dustin-lehmann/bilbolab/software/extensions/apps/content_server/content/thumbnails/db9c836b_thumb.jpg

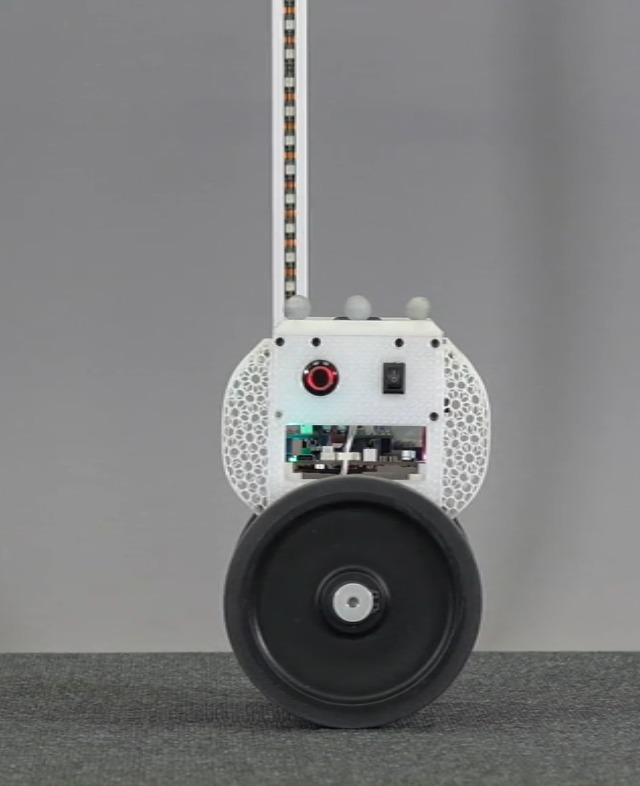
software/extensions/apps/content_server/content/thumbnails/db9c836b_thumb.jpg
