dustin-lehmann/bilbolab/software/extensions/apps/content_server/content/thumbnails/b7924501_thumb.jpg

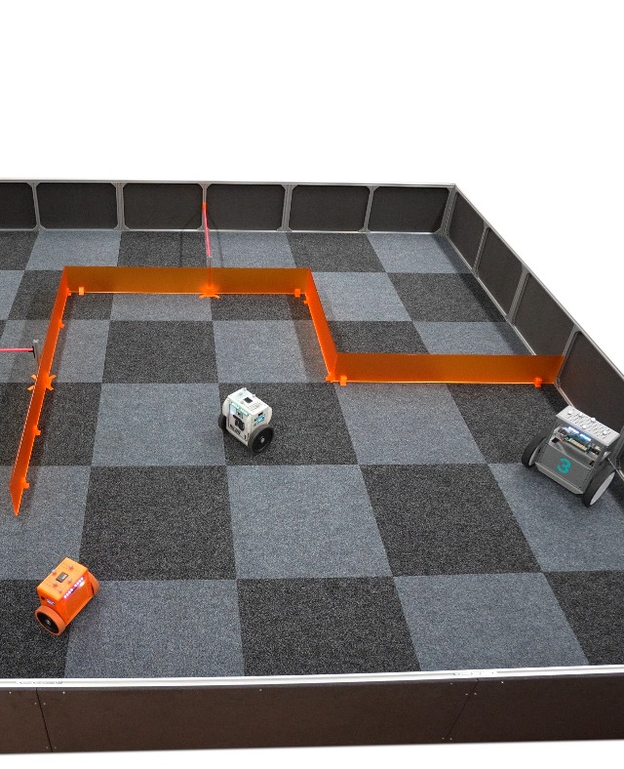
software/extensions/apps/content_server/content/thumbnails/b7924501_thumb.jpg
