dustin-lehmann/bilbolab/software/extensions/apps/content_server/pdfs/full_schematic.pdf

## Complete Schematics

Placeholder Document

Page 1 of 3

Complete Schematics - Content

Page 2 of 3

Complete Schematics - Summary

Page 3 of 3
