dustin-lehmann/bilbolab/software/extensions/apps/content_server/pdfs/main_pcb_schematic.pdf

## Main PCB Schematic

Placeholder Document

Page 1 of 3

Main PCB Schematic - Content

Page 2 of 3

Main PCB Schematic - Summary

Page 3 of 3
