dustin-lehmann/bilbolab/software/robots/bilbo/tools/plotting/examples/output/lines.pdf

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

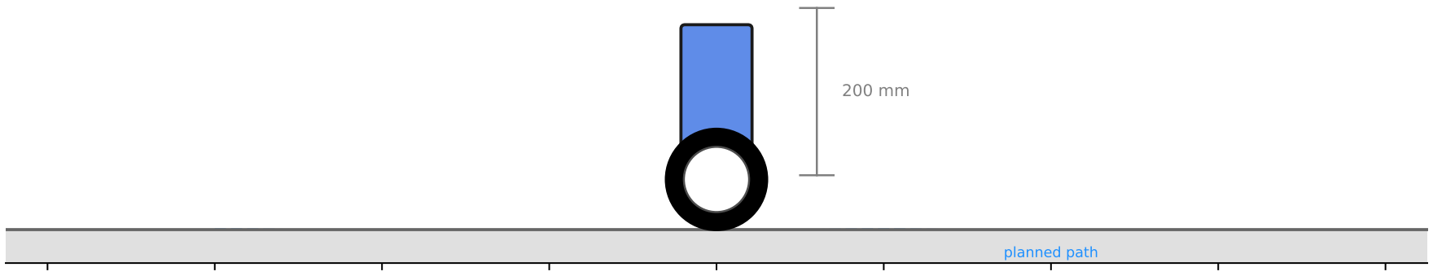
[picture p4: figure]
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
