dustin-lehmann/bilbolab/software/core/utils/plotting/examples/plot_latex.png

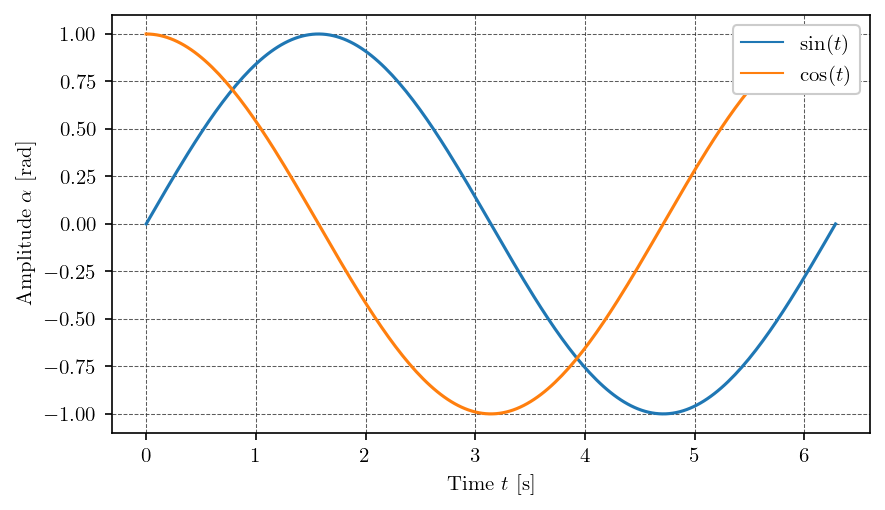
software/core/utils/plotting/examples/plot_latex.png
