dustin-lehmann/bilbolab/software/extensions/apps/content_server/content/folders/b358b188/subfolders/ef9b0147/items/b7924501/files/placeholder.png

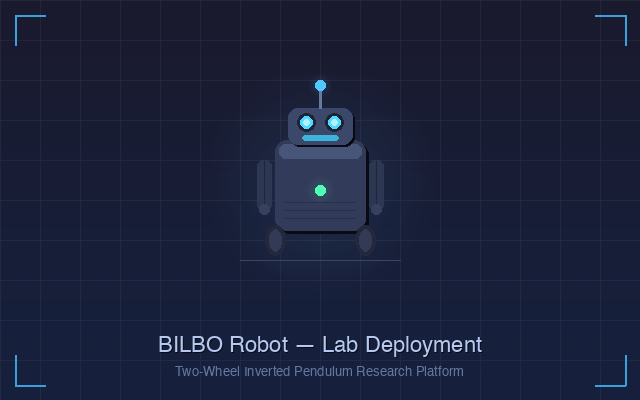
software/extensions/apps/content_server/content/folders/b358b188/subfolders/ef9b0147/items/b7924501/files/placeholder.png
