dustin-lehmann/bilbolab/software/extensions/apps/content_server/content/thumbnails/b230edec_thumb.jpg

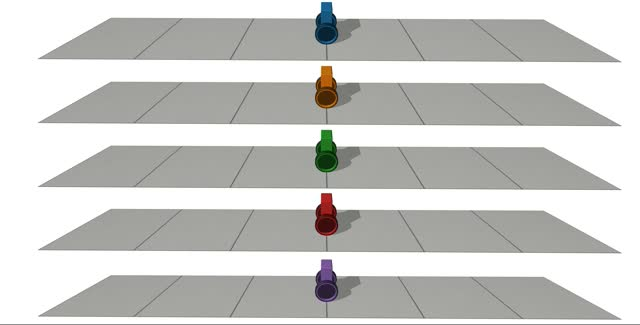
software/extensions/apps/content_server/content/thumbnails/b230edec_thumb.jpg
