dustin-lehmann/bilbolab/software/extensions/apps/content_server/content/thumbnails/thumbnail.jpg

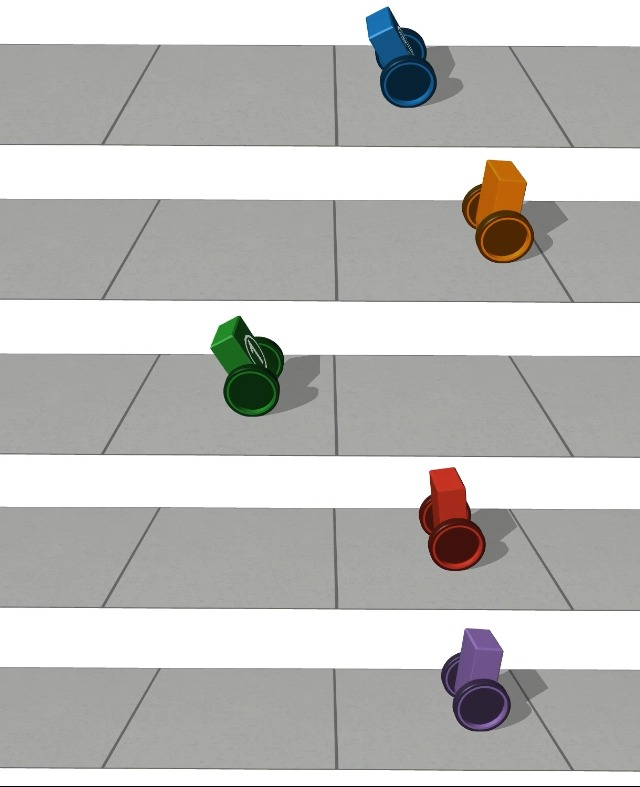
software/extensions/apps/content_server/content/thumbnails/thumbnail.jpg
