dustin-lehmann/bilbolab/software/extensions/apps/content_server/figures/chapter_deps.png

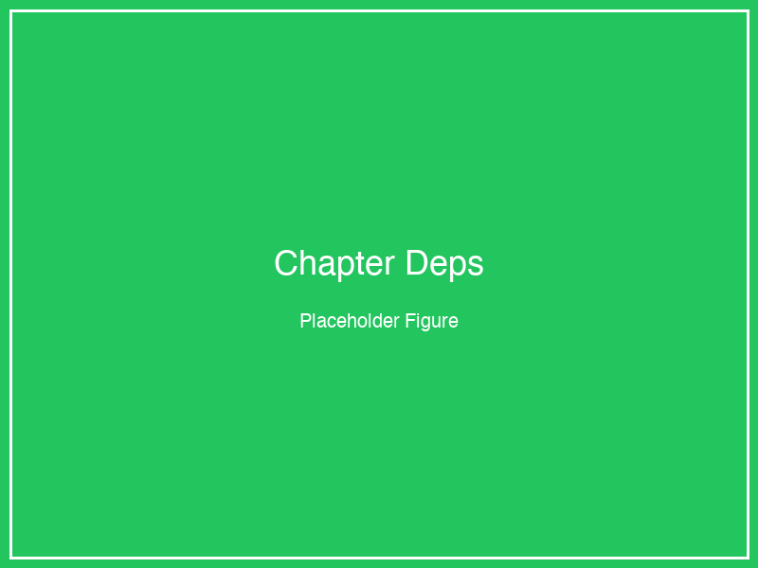
software/extensions/apps/content_server/figures/chapter_deps.png
