dustin-lehmann/bilbolab/software/extensions/apps/content_server/thumbnails/balancing_control.png

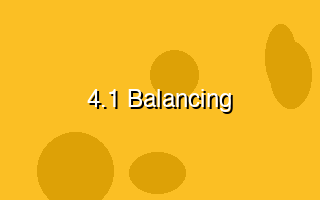
software/extensions/apps/content_server/thumbnails/balancing_control.png
