dustin-lehmann/bilbolab/software/extensions/apps/content_server/thumbnails/control.png

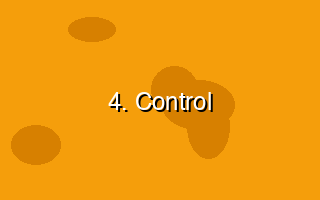
software/extensions/apps/content_server/thumbnails/control.png
