dustin-lehmann/bilbolab/software/extensions/apps/content_server/thumbnails/disturbance_rejection.png

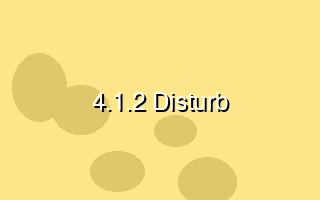
software/extensions/apps/content_server/thumbnails/disturbance_rejection.png
