dustin-lehmann/bilbolab/software/extensions/apps/content_server/thumbnails/dynamic_model.png

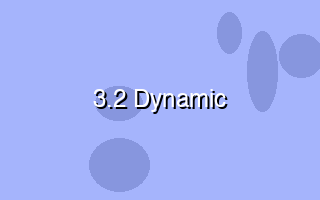
software/extensions/apps/content_server/thumbnails/dynamic_model.png
