dustin-lehmann/bilbolab/software/extensions/apps/content_server/thumbnails/estimation.png

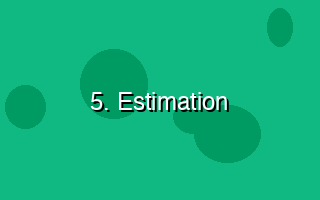
software/extensions/apps/content_server/thumbnails/estimation.png
