dustin-lehmann/bilbolab/software/extensions/apps/content_server/thumbnails/interactive.png

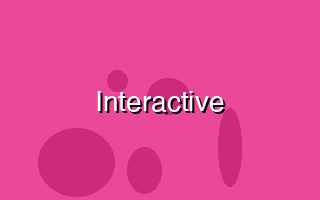
software/extensions/apps/content_server/thumbnails/interactive.png
