dustin-lehmann/bilbolab/software/extensions/apps/content_server/thumbnails/kinematic_model.png

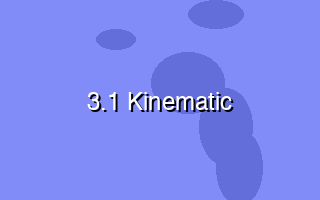
software/extensions/apps/content_server/thumbnails/kinematic_model.png
