dustin-lehmann/bilbolab/software/extensions/apps/content_server/thumbnails/lqr_design.png

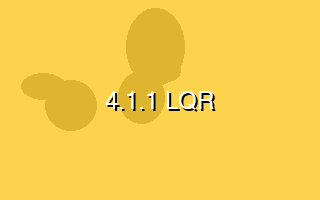
software/extensions/apps/content_server/thumbnails/lqr_design.png
