dustin-lehmann/bilbolab/software/extensions/apps/content_server/thumbnails/modeling.png

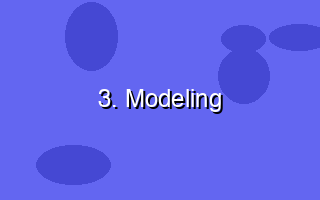
software/extensions/apps/content_server/thumbnails/modeling.png
