dustin-lehmann/bilbolab/software/extensions/apps/content_server/thumbnails/point_to_point.png

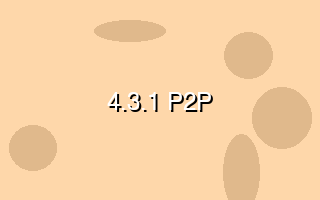
software/extensions/apps/content_server/thumbnails/point_to_point.png
