dustin-lehmann/bilbolab/software/extensions/apps/content_server/thumbnails/position_control.png

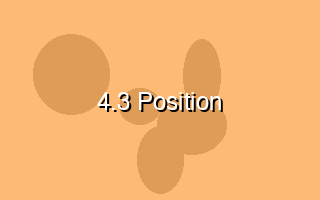
software/extensions/apps/content_server/thumbnails/position_control.png
