dustin-lehmann/bilbolab/software/extensions/apps/content_server/thumbnails/trajectory_following.png

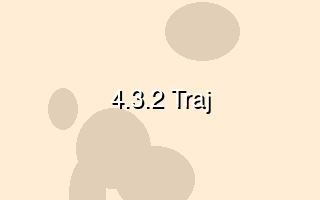
software/extensions/apps/content_server/thumbnails/trajectory_following.png
