dustin-lehmann/bilbolab/software/extensions/apps/content_server/thumbnails/velocity_control.png

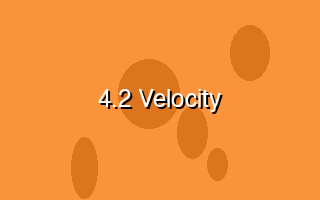
software/extensions/apps/content_server/thumbnails/velocity_control.png
