dustin-lehmann/bilbolab/software/extensions/apps/content_server/thumbnails/videos.png

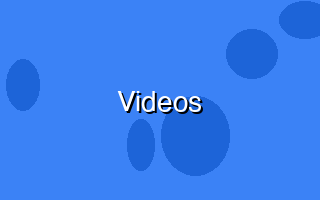
software/extensions/apps/content_server/thumbnails/videos.png
