dustin-lehmann/bilbolab/software/robots/bilbo/configs/references/bumped_reference_harder_break_gentle.png

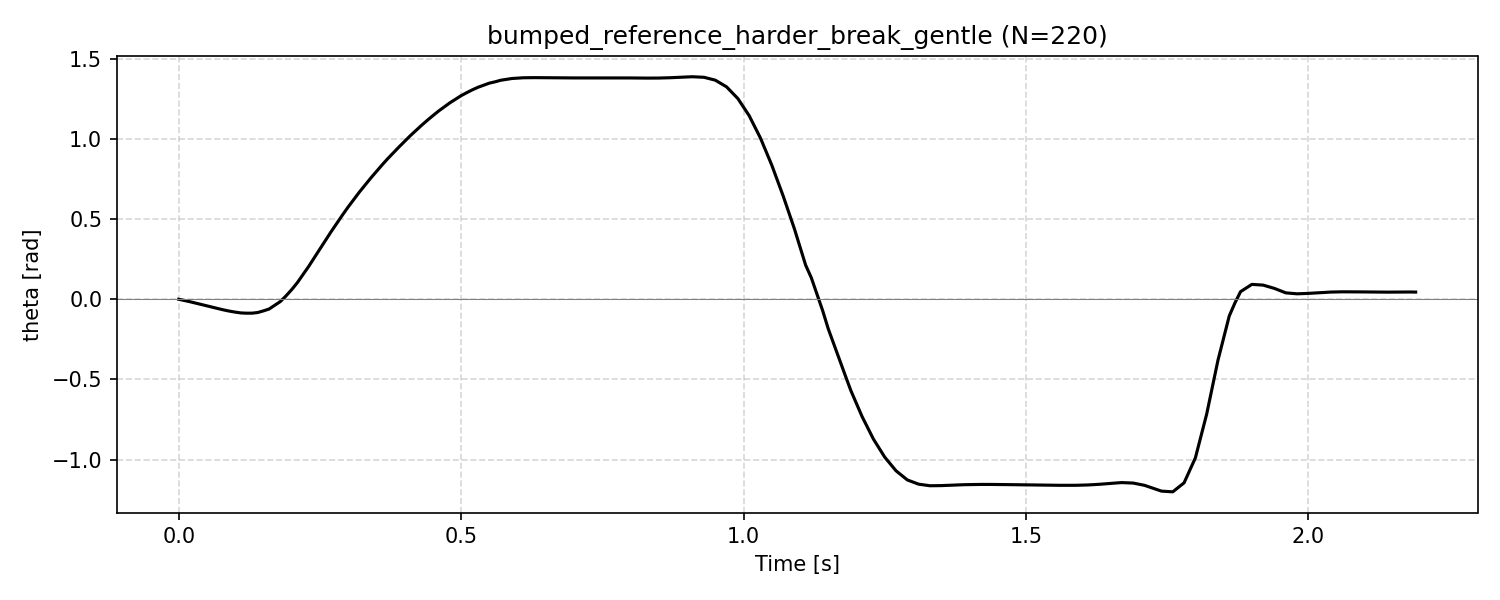
software/robots/bilbo/configs/references/bumped_reference_harder_break_gentle.png
