dustin-lehmann/bilbolab/software/robots/bilbo/tools/plotting/examples/output/lines.png

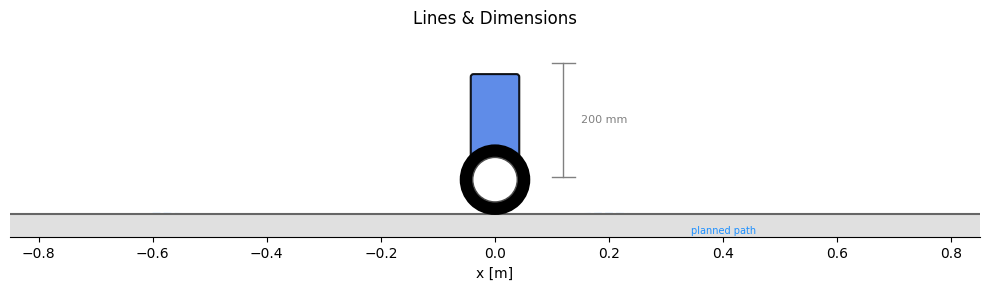
software/robots/bilbo/tools/plotting/examples/output/lines.png
