dustin-lehmann/bilbolab/software/robots/bilbo/tools/plotting/examples/output/multiple_bilbos.png

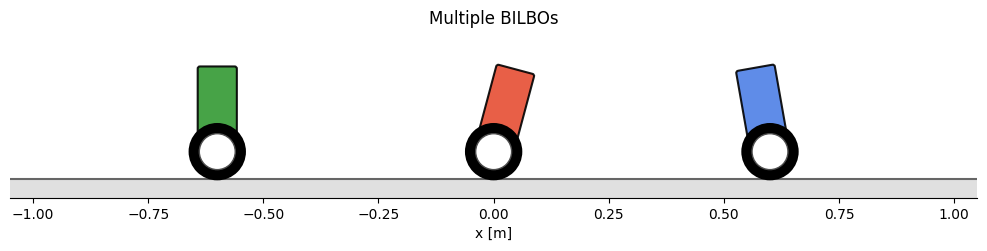
software/robots/bilbo/tools/plotting/examples/output/multiple_bilbos.png
