dustin-lehmann/bilbolab/software/extensions/apps/content_server/pdfs/bom.pdf

## Bill of Materials

Placeholder Document

Page 1 of 3

Bill of Materials - Content

Page 2 of 3

Bill of Materials - Summary

Page 3 of 3
