dustin-lehmann/bilbolab/material/expo/Anleitung_Stand-EF-11_IdeenExpo_2 copy.pdf

## STEUERUNG BALANCIERENDER ROBOTER

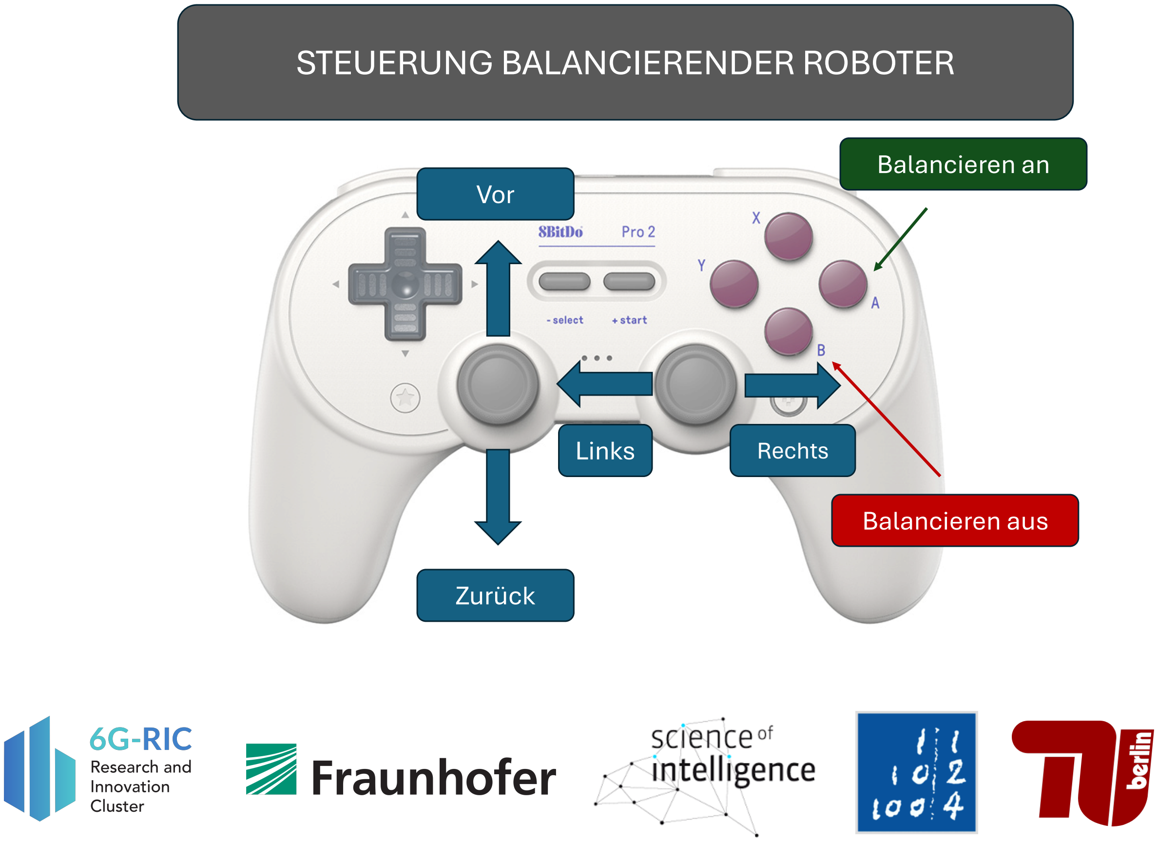
[picture p29: page 1]

Vor

Zurück

Links | Rechts

Balancieren an

Balancieren aus
