dustin-lehmann/bilbolab/software/robots/bilbo/configs/references/ref_test.png

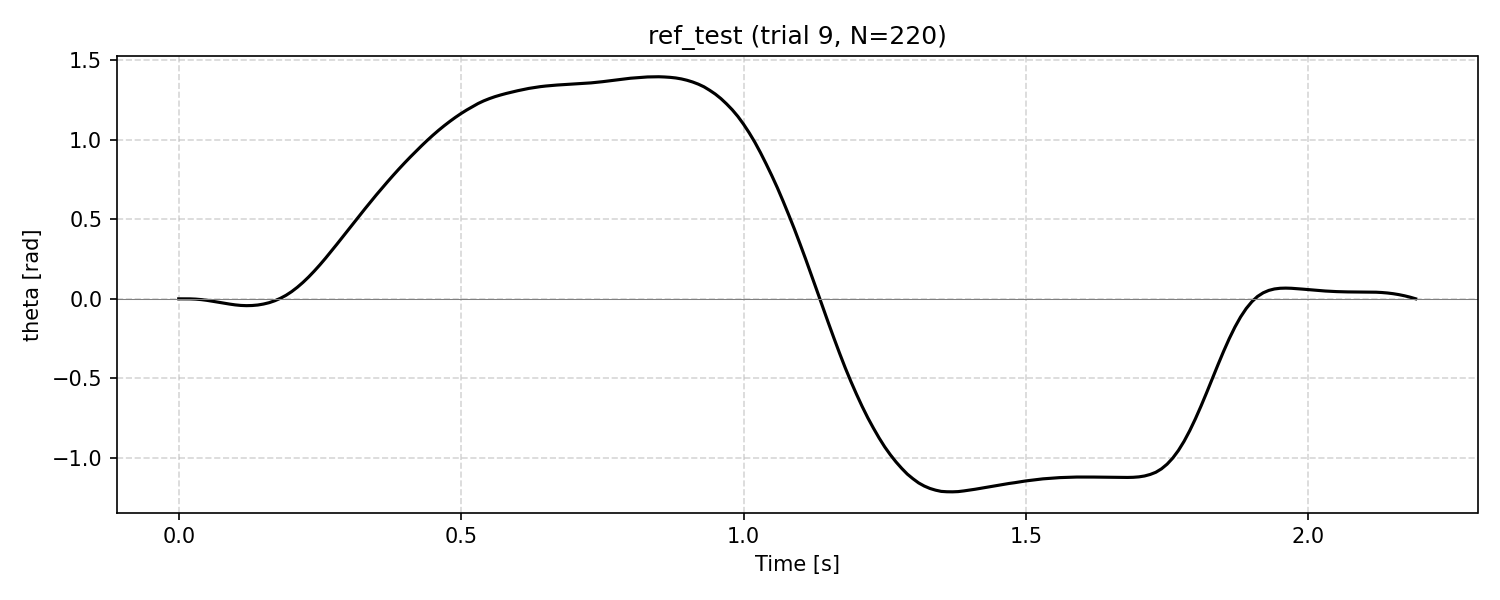
software/robots/bilbo/configs/references/ref_test.png
