dustin-lehmann/bilbolab/software/robots/bilbo/configs/references/ref_test_shifted.png

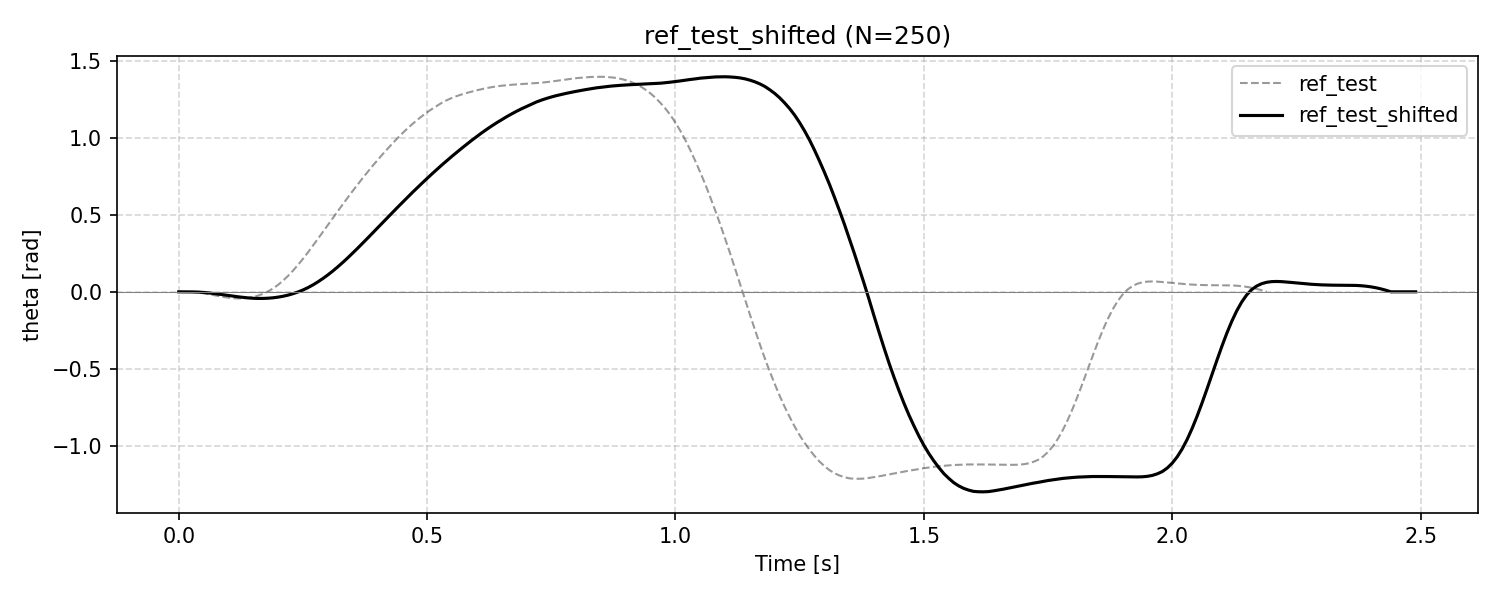
software/robots/bilbo/configs/references/ref_test_shifted.png
