dustin-lehmann/bilbolab/software/robots/bilbo/configs/references/ref_test_shifted_unbumped.png

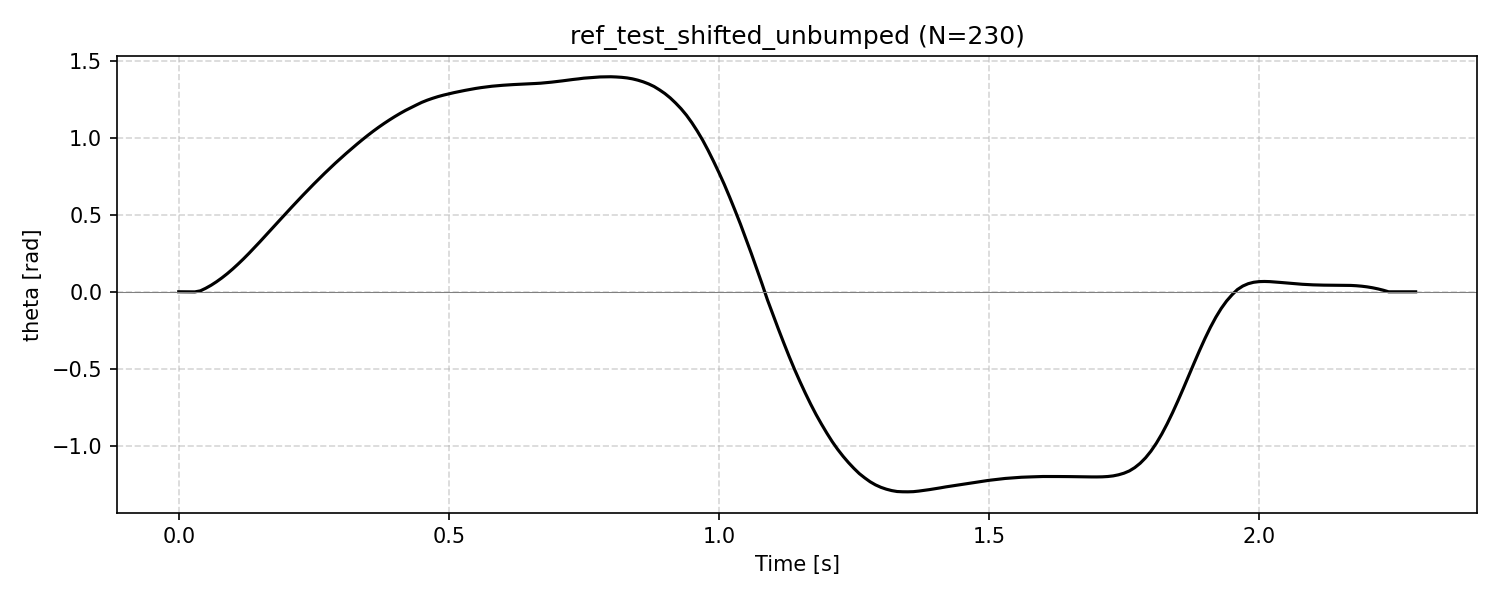
software/robots/bilbo/configs/references/ref_test_shifted_unbumped.png
