dustin-lehmann/bilbolab/software/robots/bilbo/tools/plotting/examples/output/multiple_bilbos.pdf

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

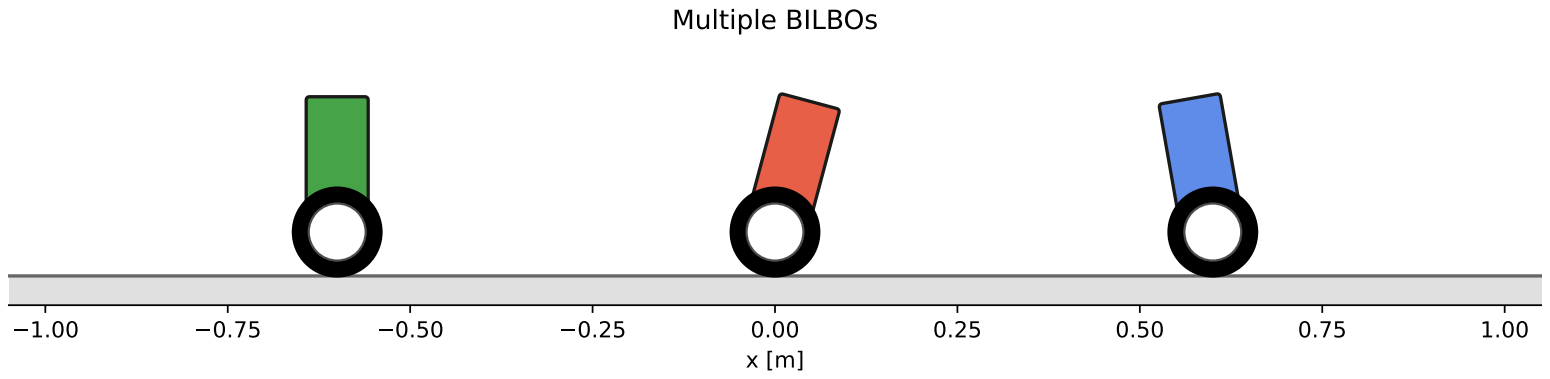
[picture p33: page 1]
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
