dustin-lehmann/bilbolab/robots/elrond/firmware/cubeid-project/Core/Inc/main.h

#define LED2_Pin GPIO_PIN_3
#define LED2_GPIO_Port GPIOE
#define SIDE_BUTTON_2_Pin GPIO_PIN_0
#define SIDE_BUTTON_2_GPIO_Port GPIOC
#define SIDE_BUTTON_1_Pin GPIO_PIN_1
#define SIDE_BUTTON_1_GPIO_Port GPIOC
#define BUTTON_LED_1_Pin GPIO_PIN_0
#define BUTTON_LED_1_GPIO_Port GPIOA
#define BUTTON_LED_2_Pin GPIO_PIN_1
#define BUTTON_LED_2_GPIO_Port GPIOA
#define UART_RESET_INTERRUPT_Pin GPIO_PIN_2
#define UART_RESET_INTERRUPT_GPIO_Port GPIOB
#define UART_RESET_INTERRUPT_EXTI_IRQn EXTI2_IRQn
#define NEW_SAMPLES_INDICATOR_Pin GPIO_PIN_9
#define NEW_SAMPLES_INDICATOR_GPIO_Port GPIOE
#define LED1_Pin GPIO_PIN_15
#define LED1_GPIO_Port GPIOE
#define CS_IMU_Pin GPIO_PIN_12
#define CS_IMU_GPIO_Port GPIOB
