dustin-lehmann/bilbolab/(commit log)

2025-04-03 [python] added addresses to low level functions, additions to actuator class in python
2025-04-11 [Fix][Firmware][dynamixel.cpp] fixed use after free in dynamixel handler, was due to timeout from motor
    [dynamixel.cpp, dynamixel.h, firmware.cpp, main.py, setting.h]
2025-04-15 [Feature][firmware][dynamixel] added communication and hardware error check function, used these functions in startup
    [dynamixel.cpp, dynamixel.h, main.py, setting.h]
2025-04-15 [Feature][Firmware][Drive] added MAB specific can in core_lib, new drive structure for different motors
2025-04-16 [Fix][Firmware][dynamixel] Fixed the startupcheck for the motors, now working
    [dynamixel.cpp, dynamixel.h, main.py]
2025-04-25 [Fix][firmware][mab_motors, can_mab] Fixed communication between motors and stm32. Read possible now
    [elrond_firmware_project.ioc, firmware.cpp, firmware.hpp, mab_motor_fdcan.cpp, mab_motor_fdcan.h, main.c, main.py]
2025-05-05 [Fix][mab_motor_fdcan & bilbo_drive] fixed motor loop racecondition
    [bilbo_drive.cpp, firmware.cpp, firmware_settings.h, mab_motor_fdcan.cpp, mab_motor_fdcan.h, main.py, twipr_control.cpp]
2025-06-04 Improve joystick controls, trajectory testing, and firmware config
    Added joystick button mappings for trajectory testing and experiment control. Enabled trajectory logging, saving, and plotting features with enhanced flexibility for experiments. Fixed GPIO configurations
    [bilbo_logging.py, elrond_firmware_project.ioc, firmware.cpp, mab_motor_fdcan.h, main.c, main.py]
2025-06-17 Enhance trajectory testing, joystick mapping, and actuator height control
    Refined joystick button configurations for actuator height adjustments. Improved trajectory test handling with additional signals, data saving, and experiment flexibility. Updated safety constraints and logging for actuator positions.
2025-10-04 reduction test
    [ControlConfig.txt, log.csv, log1.csv, samples.csv]
2025-12-16 some fixes for Positioncontrol
    [stm32_control.py]
2026-01-15 funktionierender Stand mit position vor develop reset
    [ekf.cpp, ekf.h, twipr_control.cpp, twipr_position_control.cpp]
2026-03-14 Update CubeIDE project: HAL 1.13.0, add SPI3, upgrade FreeRTOS
    Upgrade STM32Cube FW_H7 from 1.12.1 to 1.13.0 and CubeMX from 6.16.1
    to 6.17.0. Add SPI3 peripheral (TX-only simplex master on PC10/PC12).
    Update CMSIS-RTOS to v2 API. Regenerated HAL drivers and middleware.
2026-03-14 Refactor SPI sample transfer to ring buffer and add firmware info struct
    Replace single TX buffer with ring buffer architecture for SPI sample
    batching. Add event-driven sample transmission via callback. Add
    firmware_info_t struct exposing board revision, model type, and drive
    interface. Clean up LED abstraction (rc_led_strip), fix sensor enum
    underlying type.
    [bilbo_balancing_control.h, bilbo_communication.cpp, bilbo_communication.h, bilbo_control.cpp, bilbo_drive.h, bilbo_drive_motor.h, bilbo_errors.h, bilbo_estimation.h]
2026-03-14 Rebuild precompiled firmware for all rev3/rev4 variants
    Updated hex files reflecting SPI ring buffer refactoring,
    HAL 1.13.0 upgrade, and SPI3 peripheral addition.
2026-03-14 Remove deprecated core utils, consolidate remaining modules
    Delete 43 deprecated utility files (motion planning, legacy websockets,
    bitmap, graphs, images, mdns flat module, misc, thread_worker, etc.).
    Consolidate remaining utils: enhanced csv_utils with cached dataclass
    conversion, expanded ctypes_utils and dict_utils, improved logging_utils
    with startup banner/section helpers, convert mdns to package. Move
    network/button/bluetooth to core.hardware (separate commit).
2026-03-14 Refactor host experiment framework, testbed management, and clean up legacy code
    Overhaul experiment system: migrate to centralized core.utils.experiments
    framework, add experiment designer widget, action events, and report
    templates. Refactor testbed manager with externalized YAML definitions and
    origin management. Update BILBO robot interfaces for new import paths.
    Remove legacy simulation code, plotting extension, and BILBO_Game project.
    Clean up Frodo robot import paths for core utils refactoring.
2026-03-14 Refactor on-robot experiment, testbed, and simulation systems
    Experiment: Replace old framework with BILBO_Experiment using core
    experiment engine. Add action events, stop command, trajectory status.
    Remove deprecated experiment parser and description files.
    Testbed: Externalize config to YAML files, add origin management with
    dynamic OptiTrack origin switching and coordinate transforms.
    Simulation: Rewrite PID controllers with anti-windup, D-filter, rate
    limiting. Add feedforward model, heading hold, position control refactor.
    Update configs, lowlevel addresses, and logging for new systems.
    [hardware.yaml]
2026-03-14 Improve startup logging, initialization sequence, and OptiTrack verbosity
    Add visual section headers and banners throughout init/start phases for
    clearer startup output. Defer TimecodeClient and background threads from
    BILBO_Common constructor to explicit start() method. Give OptiTrack its
    own startup section with synchronous wait for connection. Reduce OptiTrack
    log noise: downgrade per-marker visibility to debug, summarize rigid body
    descriptions instead of dumping full dict. Add firmware info reading
    (board revision, model, drive interface). Add ALSA warning suppression.
    Add configurable sound settings (volume, voice presets).
    [bilbo_comm_spi.py]
2026-03-14 Remove on-robot deprecated utils (symlink to core), update import paths
    Remove deprecated core/utils files visible through the symlink to
    software/core/utils (already cleaned up in the host software commit).
    Update communication imports: core.utils.network -> core.hardware.network,
    core.utils.revisions -> core.hardware.revisions. Delete test_planner.py.
    [xbox_one_s_controller-linux.yaml]
2026-03-14 Update CubeIDE settings for rev4 control board firmware
2026-03-14 Add APA102 LED strip support, fix I2C increment and UART DMA warnings
    Refactor external RGB strip to use new RobotControl_LEDStrip abstraction
    with SPI3 APA102 support. Fix narrowing conversion in I2C extender
    flush, replace volatile compound-assignment in UART DMA to avoid C++20
    warnings, and update RTOS includes to use FreeRTOS.h directly.
2026-03-14 Add APA102 SPI LED driver and LED strip abstraction header
    New hardware driver for APA102 RGB LEDs via SPI, and a unified
    RobotControl_LEDStrip interface that supports both APA102 (direct SPI)
    and extender-based LED control.
2026-03-14 Add auto-shrinking text rendering to testbed display
    Text now scales down to fit the display width, preventing overflow for
    long titles and messages on the limbo track display.
2026-03-14 Add structured logging sections and banners to application startup
    Route Logger section/banner/divider output through stderr (same stream
    as logging) to guarantee correct ordering with log messages. Add startup
    and shutdown banners to BILBO_Application, and organize init/start phases
    with section dividers in both the application and testbed manager.
    [main.py]
2026-03-15 Tune bilbo2 control params, increase default angular speed, add bottom mode widget
    - Reduce kd_linear, decel_limit, and theta_offset for bilbo2
    - Increase default max_angular_speed from 1.0 to 3.0 rad/s across all move_to_pose interfaces
    - Switch Logger formatting helpers from stderr to stdout
    - Add mode control widget to robot UI category bottom group
    - Add track.yaml control config for bilbo2
    - Lower default sound volume to 0.25
2026-03-24 Clean up WS2812 neopixel driver: remove commented-out legacy code
2026-03-26 Update core utils: fix circular import, enhance experiment framework and plotting
    - Fix circular import between core.utils.events and core.utils.time by
    deferring the import of wait_for_events/TIMEOUT into interruptible_sleep()
    - Extend experiment framework with new action types, guards, and wrapper
    improvements
    - Add tight_layout and latex rendering improvements to plotting utils
    - Update websocket server and client connection handling
    - Remove standalone example_logging.py (superseded by logging_utils)
2026-03-26 Refactor robot-side DILC experiment, enhance control and position control
    - Refactor DILC experiment into modular hook-based architecture with
    subclass overrides for LimboBar variant
    - Add enable_psi_control and disable_tracker_during_trajectory meta settings
    - Add WiFi event hooks for extra trial/experiment data (limbo bar hits/passes)
    - Override WiFi event container ID in LimboBar DILC for correct host routing
    - Reset limbo bar after reading hit state so return journey triggers fresh hit
    - Consolidate position control into bilbo_control, add PSI controller support
    - Update experiment handler with LimboBar DILC experiment support
    - Update firmware settings for bilbo2 motor configuration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
    [bilbo_logging.py]
2026-03-26 Update testbed manager, joystick control, simulation, and display devices
    - Extend testbed manager with limbo bar tracking and display integration
    - Add testbed display device with auto-shrinking text and status rendering
    - Update joystick control with improved mode switching
    - Add bilbo_control PSI forwarding, update bilbo_core initialization
    - Update track testbed definition with new limbo bar configuration
    - Enhance limbo track display with wall clock and status sections
    - Update simulation model and allpass sensor example
2026-04-10 Restructure GUI examples, fix framework bugs, and clean up repo
    GUI Examples:
    - Reorganize flat examples/ into focused subdirectories (getting_started,
    buttons, inputs, data_display, tables, plots, map, popups, layout, cli,
    media, babylon, advanced)
    - Each example demonstrates a specific widget type with interactive
    cross-widget behavior, logging to GUI terminal, and callout notifications
    - Add two Babylon 3D examples: scene showcase and robot arm with FK
    Framework Fixes:
    - Fix TextWidget.text setter to use updateConfig() instead of broken
    setText() function call that spammed JS console warnings
    - Fix MultiSelectWidget: fire selection_changed callback on value change
    - Fix BabylonVi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
    [body.SLDPRT, calibration_v3_chess_old.yaml, export_robot.SLDASM, robot_base.SLDASM, top.SLDPRT, track.SLDPRT, wheel.SLDPRT]
2026-05-25 Ignore generated TTS cache files
    Update stale gitignore path and untrack the index.json — the
    tts_files/ directory contains absolute machine-local paths and
    auto-generated mp3s that should not be in version control.
2026-05-25 Restructure control_lib: replace il/ilc with learning module
    Consolidate iterative learning code into a new lib_control/learning/
    package: cilc, iml, transfer (iitl, oneshot, direct), plus shared
    helpers (dynamics, filters, lifted systems, lti systems, vector
    generation). Removes the scattered il/, ilc.py, lifted_systems.py and
    legacy ILC_DAMN_bib.py.
2026-05-25 Refactor frodo: extract network settings into dedicated dataclass
    Split FRODO_Information into nested settings (network, camera, aruco,
    optitrack, physical_model) on both host and on-robot sides, updating
    all call sites across applications, algorithms, navigation, testbed,
    simulation, and robot modules.
2026-05-27 Restore LegendConfig, add lab-hannover testbed, fix testbed configs path
    - Restore LegendConfig dataclass in plotting.plot; AxisConfig.legend accepts LegendConfig | bool
    - Add lab-hannover testbed config and switch settings to use it
    - Fix testbed_manager to load configs from 'configs' instead of 'definitions'
    - Update bilbo2 optitrack marker assignment for new origin layout
    [bilbo2.yaml]
2026-05-27 Make opencv-python optional for CameraWidget
    Guard cv2 imports in camera.py and camera_streamer.py. When OpenCV is
    missing, CameraWidget initializes inert (empty camera list, warning
    logged) instead of failing at import.
2026-06-19 Fix CAN motor torque-mode startup race; restore watchdog with disable teardown
    Firmware (robots/bilbo/firmware):
    - SimplexMotion_CAN::start() retries setMode(TORQUE) until the motor reports
    TORQUE. checkMotor()'s startup beep leaves the motor in BEEP mode, and the
    asynchronous CAN write/readback could leave the cached mode at BEEP, making
    every setTorque() fail and faulting the drive. Retrying fixes it.
    - BILBO_Drive::start() now logs an error if a motor fails to enter torque mode
    instead of failing silently.
    - Restored the SimplexMotion motor watchdog (configureWatchdog/feedWatchdog)
    and added disableWatchdog(): when BILBO_DRIVE_WATCHDOG_ENABLE is 0, init
    actively tears down any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
    [bilbo-ie-1.yaml, bilbo2.yaml, bilbo_drive.cpp, bilbo_drive_motor.h, default.yaml, firmware_settings.h]
2026-06-23 Add IdeenExpo 2026 app, firmware nudge recovery, and camera streaming robustness
    IdeenExpo 2026 application (software/robots/bilbo/applications/ideenexpo_2026/):
    new app mirroring the standard BILBO application with expo-specific building
    blocks — master-joystick control with Full/Assist override modes, per-robot
    input scaling and trigger "turbo" boost, camera/big-view GUI pages, master GUI
    folder, and an `expo` CLI namespace. Adds bilbo-ie-2/ie-3 robot configs and a
    bilbo_flash utility; zeroes bilbo-ie-1 theta_offset.
    Firmware "nudge" (free-from-wall): one-shot open-loop PWM move (mode 10) usable
    only in OFF mode and only when the robot is lying over. Direction is chosen from
    theta to ro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
2026-07-14 Add standalone Tentacle Sync MTC timecode reader
    Self-contained extract of core/utils/timecode/mtc.py that decodes MIDI
    Time Code quarter-frames from a Tentacle Sync over USB MIDI and fires a
    callback with each decoded timecode plus the wall-clock time, for
    aligning external recordings. Depends only on mido/python-rtmidi.
2026-08-05 Add FRODO art project line detection app with camera frame events
    - New applications/art_project with AP_LineDetector streaming annotated
    frames via VideoStreamer on port 5001
    - PyCamera: emit frame callback/event on every takeFrame()
    - Restore aruco detector streaming demo in __main__
    - FRODO main.py: set external RGB LED to green on start
    - Bump edge-tts to ~=7.2 across requirements and pyproject
2026-08-05 Fix joystick thread attribute typo in FRODO interfaces
    self_joystick_thread was missing a dot, so _joystick_thread never
    existed and the disconnect handler crashed with AttributeError. Also
    initialize the attribute in __init__ and reset _exit_joystick_task on
    reconnect so the control loop doesn't exit immediately.
