dustin-lehmann/bilbolab/(notices)

Notices in the files:
robots/elrond/firmware/cubeid-project/Core/Inc/main.h:
Copyright (c) 2023 STMicroelectronics.
All rights reserved.
This software is licensed under terms that can be found in the LICENSE file
